kyarl/ESP32-winmonitor/misc/Mini Monitor Assembly Guide.pdf

## Downloading Everything

## All the software for this is hosted on GitHub:

## https://github.com/kyarl/ESP32-winmonitor

(CC BY-NC-SA 4.0)

Download the latest version by visiting the Releases Page: (https://github.com/kyarl/ESP32-winmonitor/releases)

## IMPORTANT: As of current, this is only tested/compatible with

windows 11 - hence “Win” Monitor.
It may in future have extended functionality for other OS.

You should be relatively comfortable with Ardunio IDE and Python for this project. If you get stuck, ask google first.

Most of the initial codebase is pretty crap, and there is lots of room for improving performance/making proper use of the S3. So, feel free/it is encouraged for you to contribute, just make sure you are aware of the project’s license.

# ESP32 Win Monitor Part 1: Software Guide

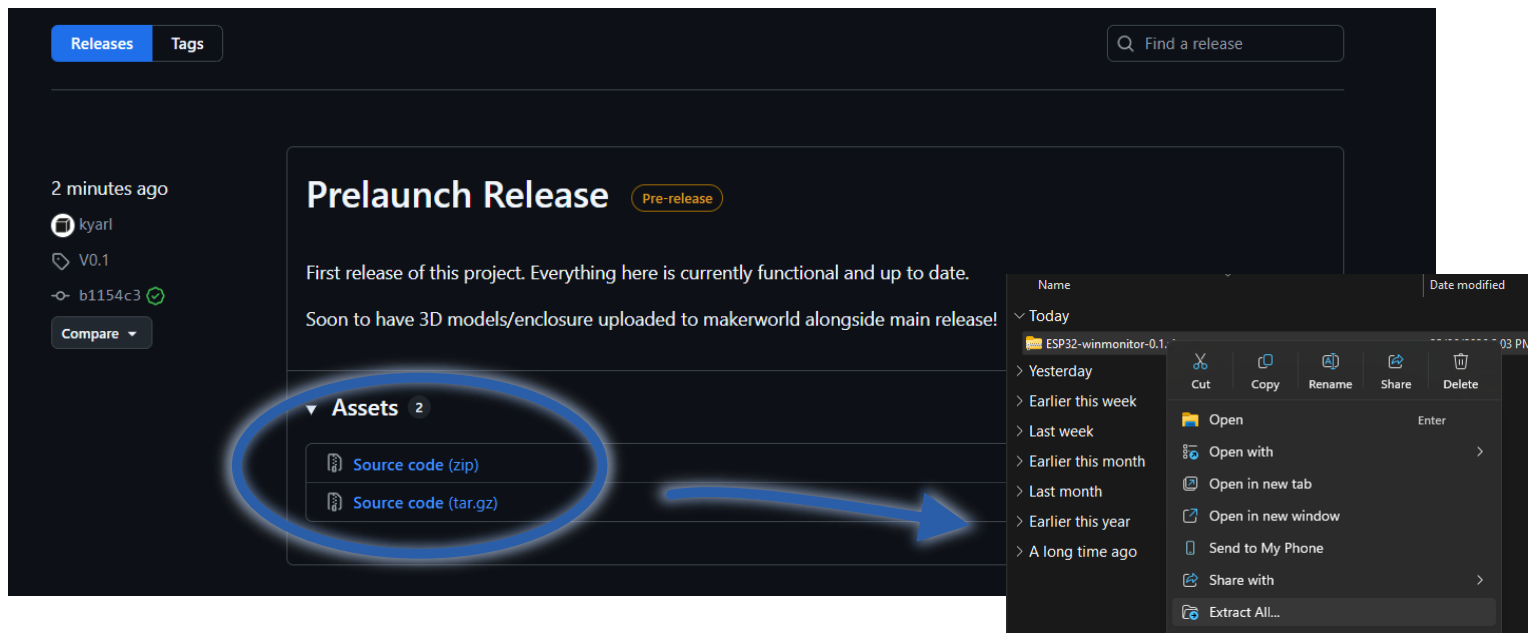
[picture p3: figure]

Download & extract the zip file which contains everything you need.

You should put the extracted files/folders somewhere they won’t be deleted, i.e. your documents folder

It will contain the following:

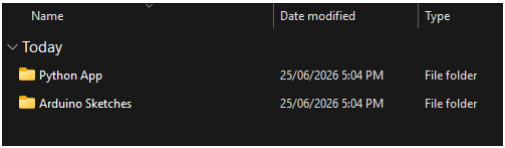
[picture p4: figure]

As the folder names suggest. One has the python app, the other has all the Arduino sketches for programming your ESP32 board.

## Uploading to ESP32 – Arduino IDE

## You don’t need to have everything wired up yet, but it might be

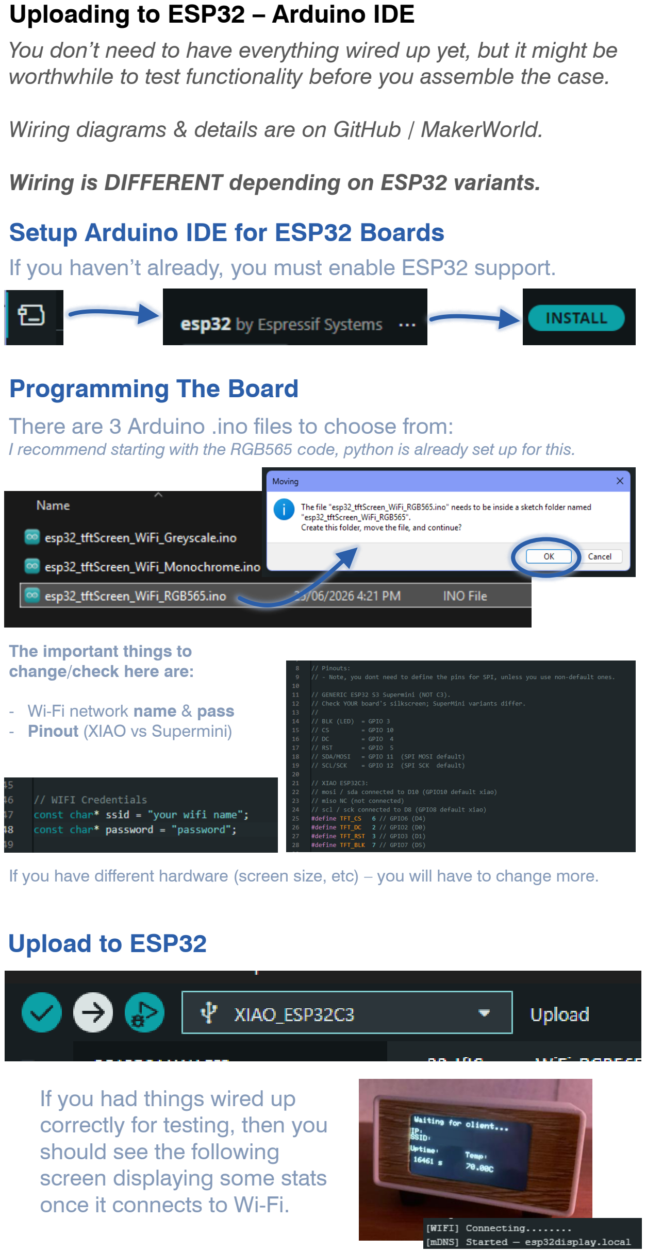
[picture p5: page 2]

worthwhile to test functionality before you assemble the case.

Wiring diagrams & details are on GitHub / MakerWorld.

Wiring is DIFFERENT depending on ESP32 variants.

## Programming The Board

The important things to
change/check here are:
- Wi-Fi network name & pass
- Pinout (XIAO vs Supermini)

## There are 3 Arduino .ino files to choose from:

I recommend starting with the RGB565 code, python is already set up for this.

## Upload to ESP32

## If you had things wired up correctly for testing, then you

## should see the following screen displaying some stats

once it connects to Wi-Fi.

## Setup Arduino IDE for ESP32 Boards

If you haven’t already, you must enable ESP32 support.

If you have different hardware (screen size, etc) – you will have to change more.

## Streaming Windows Monitor – Python App

## Now that the ESP32 is programmed, need to actually start

sending frames/images for it to display.

## VDD (Virtual Display Driver) (https://github.com/VirtualDrivers/Virtual-Display-Driver)

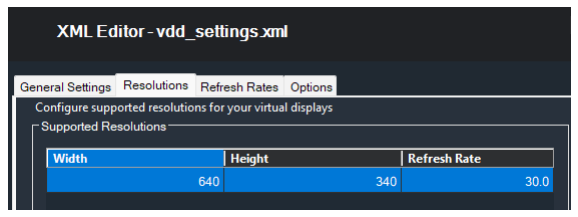
[picture p6: figure]

This is a whole other project, made by someone else, completely unrelated to me. It is NOT strictly required for this mini monitor to work, so I will not be providing excessive details on setting this up.

There may be alternatives to VDD. There also may be a newer version of VDD.

## Allows ESP32 Win Monitor to act as its own screen, rather

than just a teeny tiny copy of your main screen.

## Main settings you want to edit

## in vdd_settings.xml*:

## - Resolution: 640 x 340 - Refresh Rate: 30Hz

* Technically could be any multiple of 320x170 (SPI Screen). * And I would be surprised if can get more than 30fps on this.

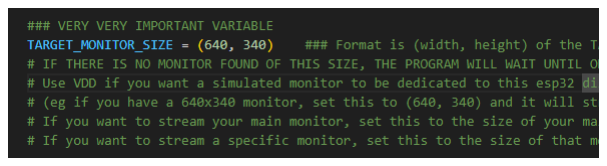
[picture p7: figure]

## Running the Python App

## When you run the python app (.pyw) for the first time, it will

create its own shortcut. You can then just use the shortcut.

If you are not using VDD.

## Editing the Python App

Adjust TARGET_MONITOR_SIZE.

If you are not using RGB565.

Comment out the appropriate modules.

If you are using VDD (at 640 x 340 resolution) and the RGB565 Arduino Sketch, then you should not have to change anything. Main things you might want to tune are in the CONFIG section. Everything else is somewhat commented anyway.

## ⁻ [THIS] (https://www.youtube.com/watch?v=Oz_cfbfUx0E) Tutorial May Help

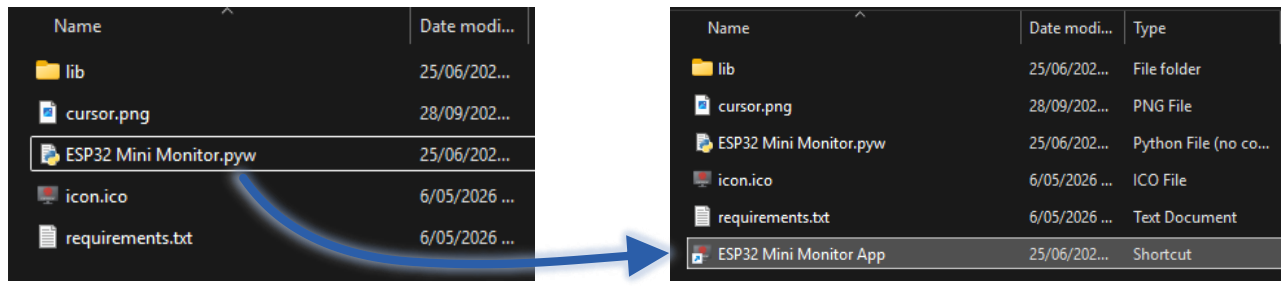
[picture p8: figure]

The python app will run as a system tray icon.

## More info on the last page of this doc!

Note: If you are running in vscode or another console for testing/debugging: use the tray icon to quit, not a Keyboard Interrupt.

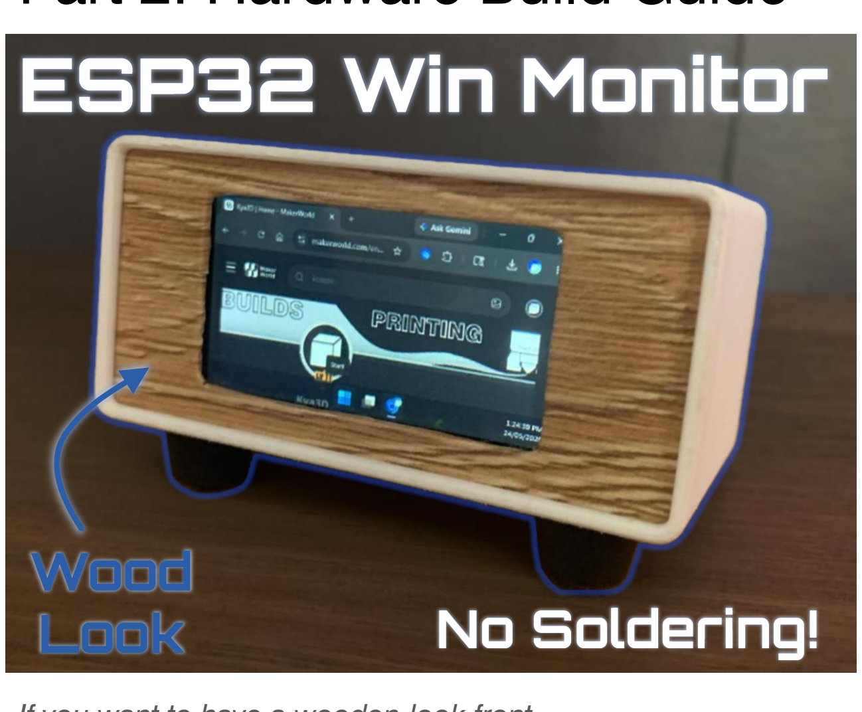
[picture p9: figure]
Wood Look; ESP32 Win Monitor; No Soldering!

## Applying Vinyl Wrap

## If you want to have a wooden-look front…

## (or any other material/texture of your choice)

## If you want to have a wooden-look front…

### (or any other material/texture of your choice)

# ESP32 Win Monitor Part 2: Hardware Build Guide

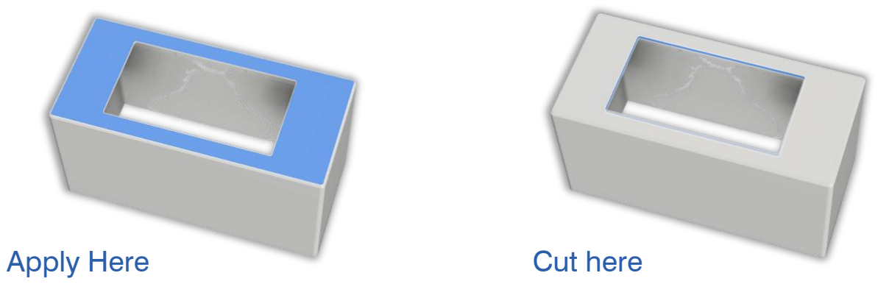
[picture p10: figure]
Apply Here; Cut here

This only needs to be applied to the front surface. There is a shroud that goes around the sides to cover up the edges (see showcase image).

It’s ok to oversize and go a bit onto the edge surfaces though! The only important area is the screen cutout, try and get that as accurate as possible!.

Do NOT cut/trim the vinyl after the screen is installed.

## Otherwise, you can always just print this part in another colour!

ESP32-C3 XIAO | ESP32-S3 Supermini

## Place the board into the dedicated slot

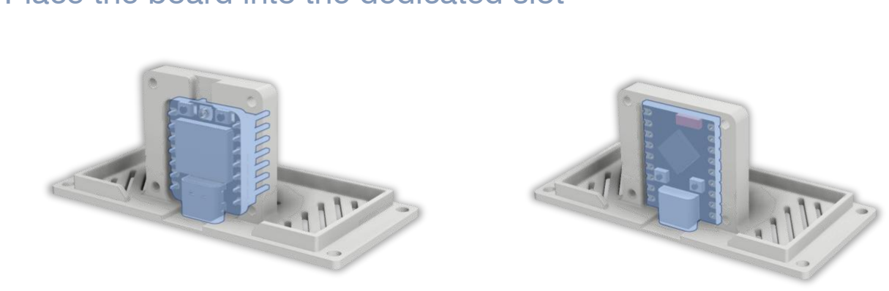
[picture p11: figure]

(XIAO ONLY) - Feed the Wi-Fi antenna through the back.

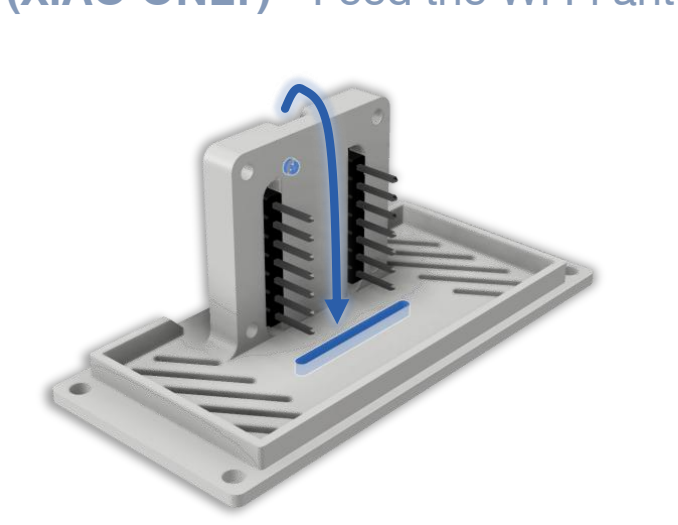
[picture p12: figure]

## Place the cover & fasten with M2 screws. Length ≥5.00mm

## Not relevant for S3

supermini.

## Assembling the ESP Mount/Back Cover

## For 2 Different board variants:

## Seeed Studio XIAO Boards & Generic ESP32-S3 Supermini §

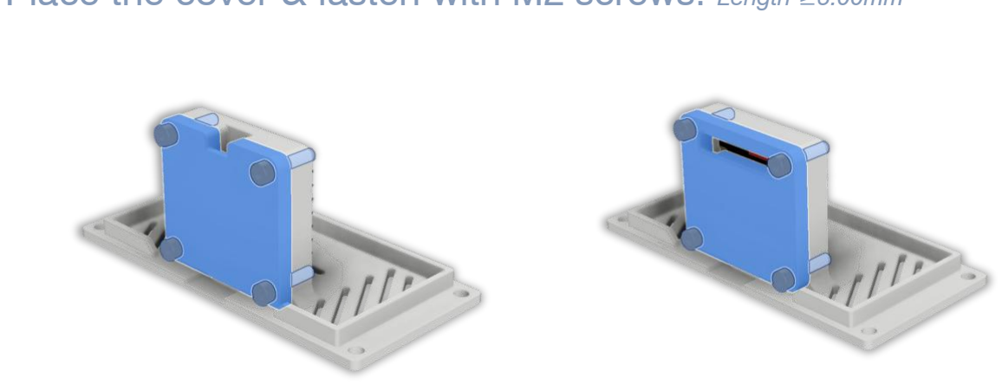
[picture p13: figure]

You can get away with using only 2 screws here (same with the screen later). Just make sure you put them in opposing corners.

Reminder: All required fasteners are on MakerWorld post.

§ The S3 supermini is cheaper (than XIAO boards) on AliExpress and is more powerful than the C3. Due to the chance that later code releases may be able to make use of the second core of the S3 for performance gains, I would strongly suggest getting an S3 supermini or S3 XIAO variant.

## Installing Screen & Rear Cover

## I would recommend only doing this AFTER connecting all

wiring / jumpers to the ESP32 after assembled in its mount.

## Wiring diagrams are on the GitHub page. I’m not going to go

## into detail here - there’s like 8 wires. Use female to female

DuPont jumper wires, shorter ones (~10cm) better.

### (About $1 on Aliexpress)

AND after applying & trimming wood vinyl (optional).

## Placing Screen In Enclosure

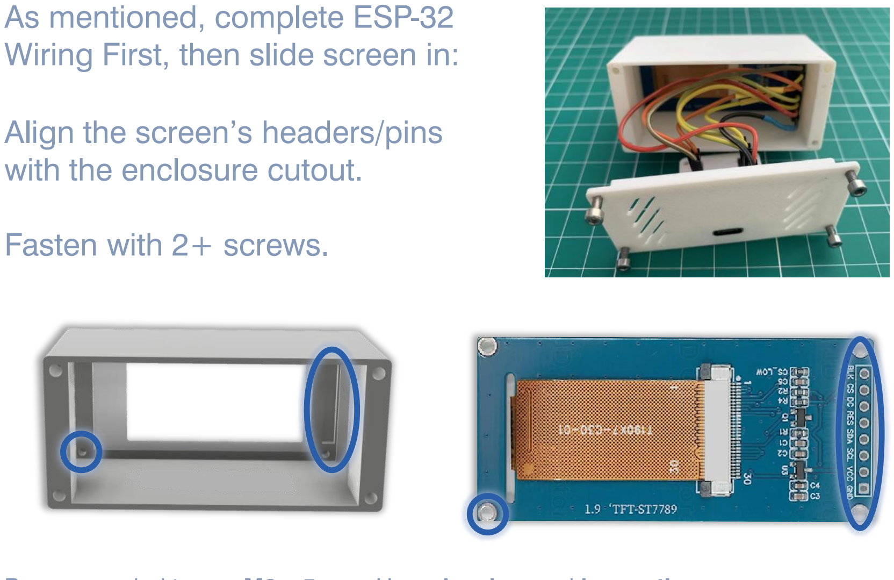
[picture p14: figure]
Align the screen’s headers/pins; with the enclosure cutout.; Fasten with 2+ screws.; As mentioned, complete ESP-32; Wiring First, then slide screen in:

Recommended to use M2 x 5 mm. Use a hex key and be gentle.
A screwdriver’s shaft will be too thick to reach screws.

Self-tapping screws also work. Enclosure hole is Ø1.85 mm, PCB is Ø2.00 mm.

## Fastening The Enclosure

Carefully push all wires & ESP32 casing into the enclosure. Fasten with M2.5 x 5mm Screws.

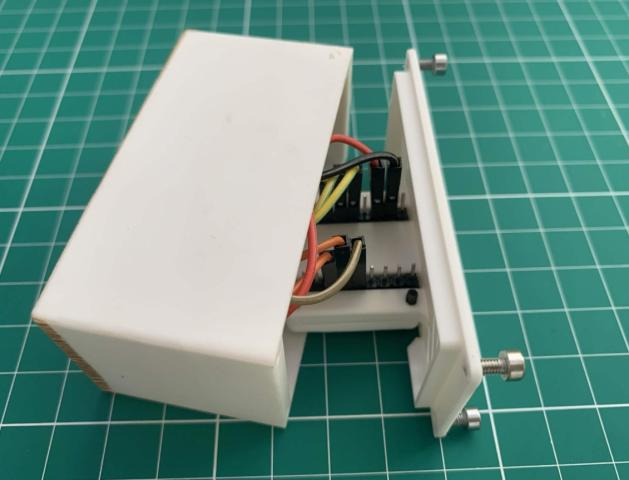
[picture p15: figure]
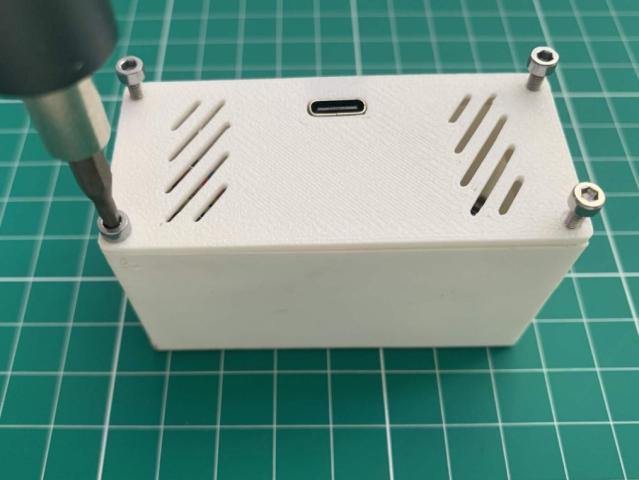
[picture p16: figure]

## Final Assembly

## Once back cover is fastened, you can add the final shroud and

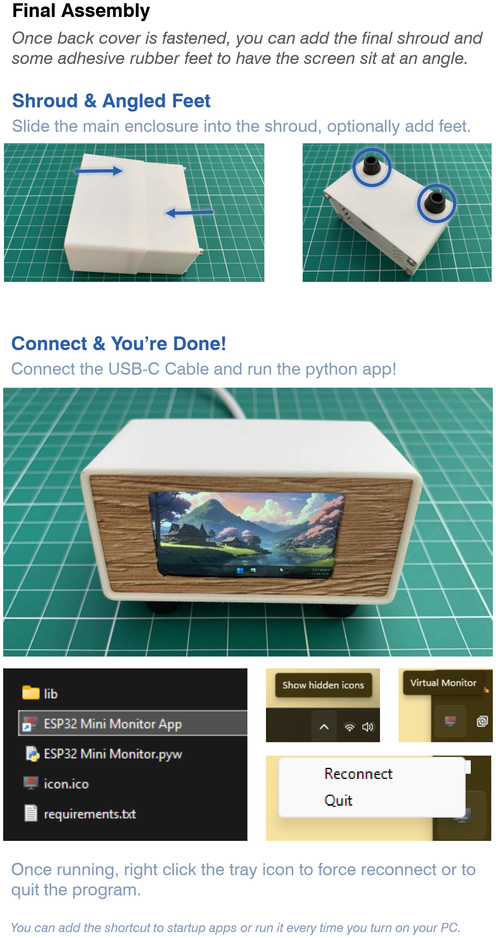
[picture p17: page 7]

some adhesive rubber feet to have the screen sit at an angle.

## Shroud & Angled Feet

Slide the main enclosure into the shroud, optionally add feet.

## Connect & You’re Done!

## Connect the USB-C Cable and run the python app!

## Once running, right click the tray icon to force reconnect or to

quit the program.

You can add the shortcut to startup apps or run it every time you turn on your PC.
