kyarl/ESP32-winmonitor/(commit log)

2026-05-06 Update README with achievable framerates
    Added achievable framerates section with performance metrics.
2026-05-06 Add wiring documentation
2026-05-06 Update README with wiring diagram and enclosure info
    Added wiring diagram and enclosure printing instructions.
2026-05-06 Adjust wiring diagram image dimensions
    Updated wiring diagram image size in README.
2026-05-06 Revise wiring diagram and mention assembly guide
    Updated wiring diagram and added assembly guide note.
2026-06-24 Document pinouts for ESP32 boards
    Added pinout comments for ESP32 S3 Supermini and XIAO ESP32C3.
2026-06-24 Update pin definitions and add comments for ESP32
    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
2026-06-24 Refactor pin definitions and add board comments
    Updated pin definitions and added comments for ESP32 board configurations.
2026-06-24 Revise wiring diagrams in README.md
    Updated wiring diagrams for XIAO ESP32 C3 & ESP32 S3 Supermini with improved image formatting.
2026-06-24 Fix formatting for wiring diagrams in README
2026-06-24 Fix typo in enclosure description in README.md
2026-06-24 Update README with additional USB CDC option
    Clarified the potential use of RP2350 for USB CDC to improve framerates.
2026-06-25 Update ESP32 Mini Monitor.pyw
2026-06-25 Create Mini Monitor Assembly Guide.pdf
2026-06-25 Update Mini Monitor Assembly Guide.pdf
2026-06-25 Revise README with new enclosure link and diagrams
    Updated links and improved clarity in wiring diagram section.
